afonsus1997/Yet-Another-Nixie-Clock/Hardware/Yet-Another-Nixie-Clock-Face/Yet-Another-Nixie-Clock-Face.kicad_pcb

## KiCad design Hardware/Yet-Another-Nixie-Clock-Face/Yet-Another-Nixie-Clock-Face.kicad_pcb (2025-10-29)

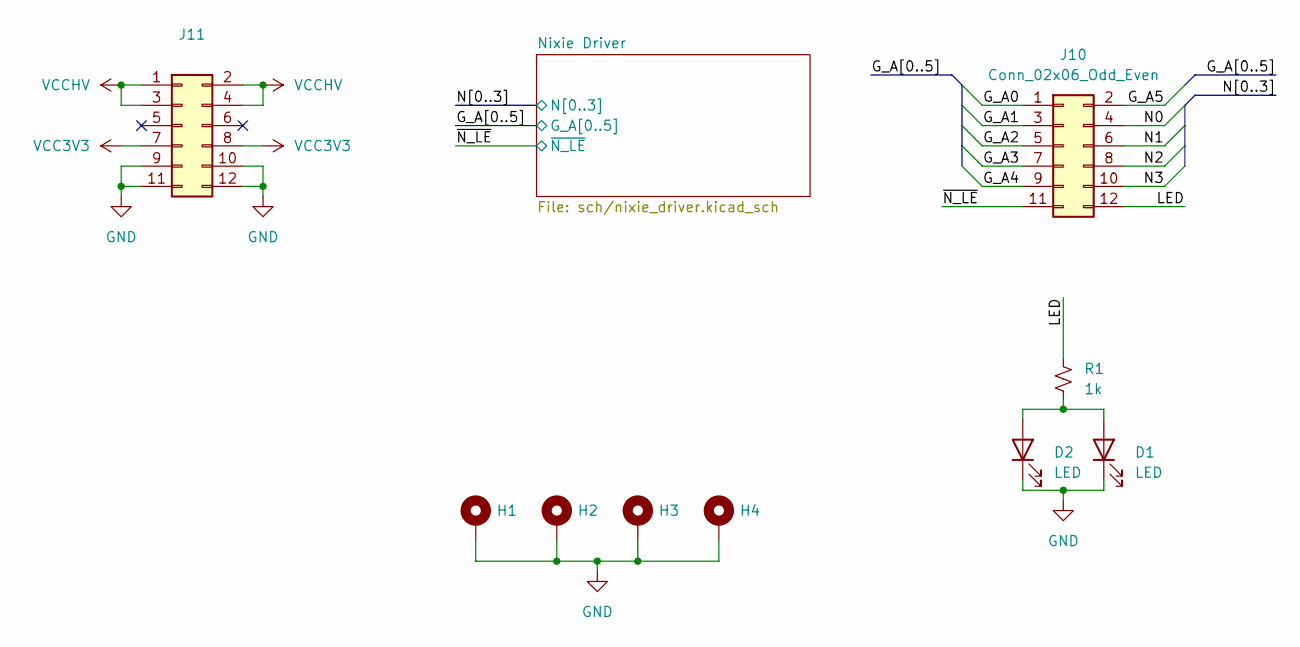
[picture p1: schematic Yet-Another-Nixie-Clock-Face.kicad_sch]

Parts:
D1, D2: LED; LED_0603_1608Metric
H1, H2, H3, H4: MountingHole_Pad; MountingHole_3.2mm_M3_Pad
J10, J11: Conn_02x06_Odd_Even; PinHeader_2x06_P2.54mm_Vertical_SMD; LCSC C3294464
R1: 1k; R_0603_1608Metric; LCSC C22548

Connections:
/G_A0: J10.1; also elsewhere on the board
/G_A1: J10.3; also elsewhere on the board
/G_A2: J10.5; also elsewhere on the board
/G_A3: J10.7; also elsewhere on the board
/G_A4: J10.9; also elsewhere on the board
/G_A5: J10.2; also elsewhere on the board
/LED: J10.12, R1.2
/N0: J10.4; also elsewhere on the board
/N1: J10.6; also elsewhere on the board
/N2: J10.8; also elsewhere on the board
/N3: J10.10; also elsewhere on the board
/~N_LE: J10.11; also elsewhere on the board
GND: D1.1 (K), D2.1 (K), H1.1, H2.1, H3.1, H4.1, J11.9, J11.10, J11.11, J11.12; also elsewhere on the board
unnamed: D1.2 (A), D2.2 (A), R1.1
VCC3V3: J11.7, J11.8; also elsewhere on the board
VCCHV: J11.1, J11.2, J11.3, J11.4; also elsewhere on the board

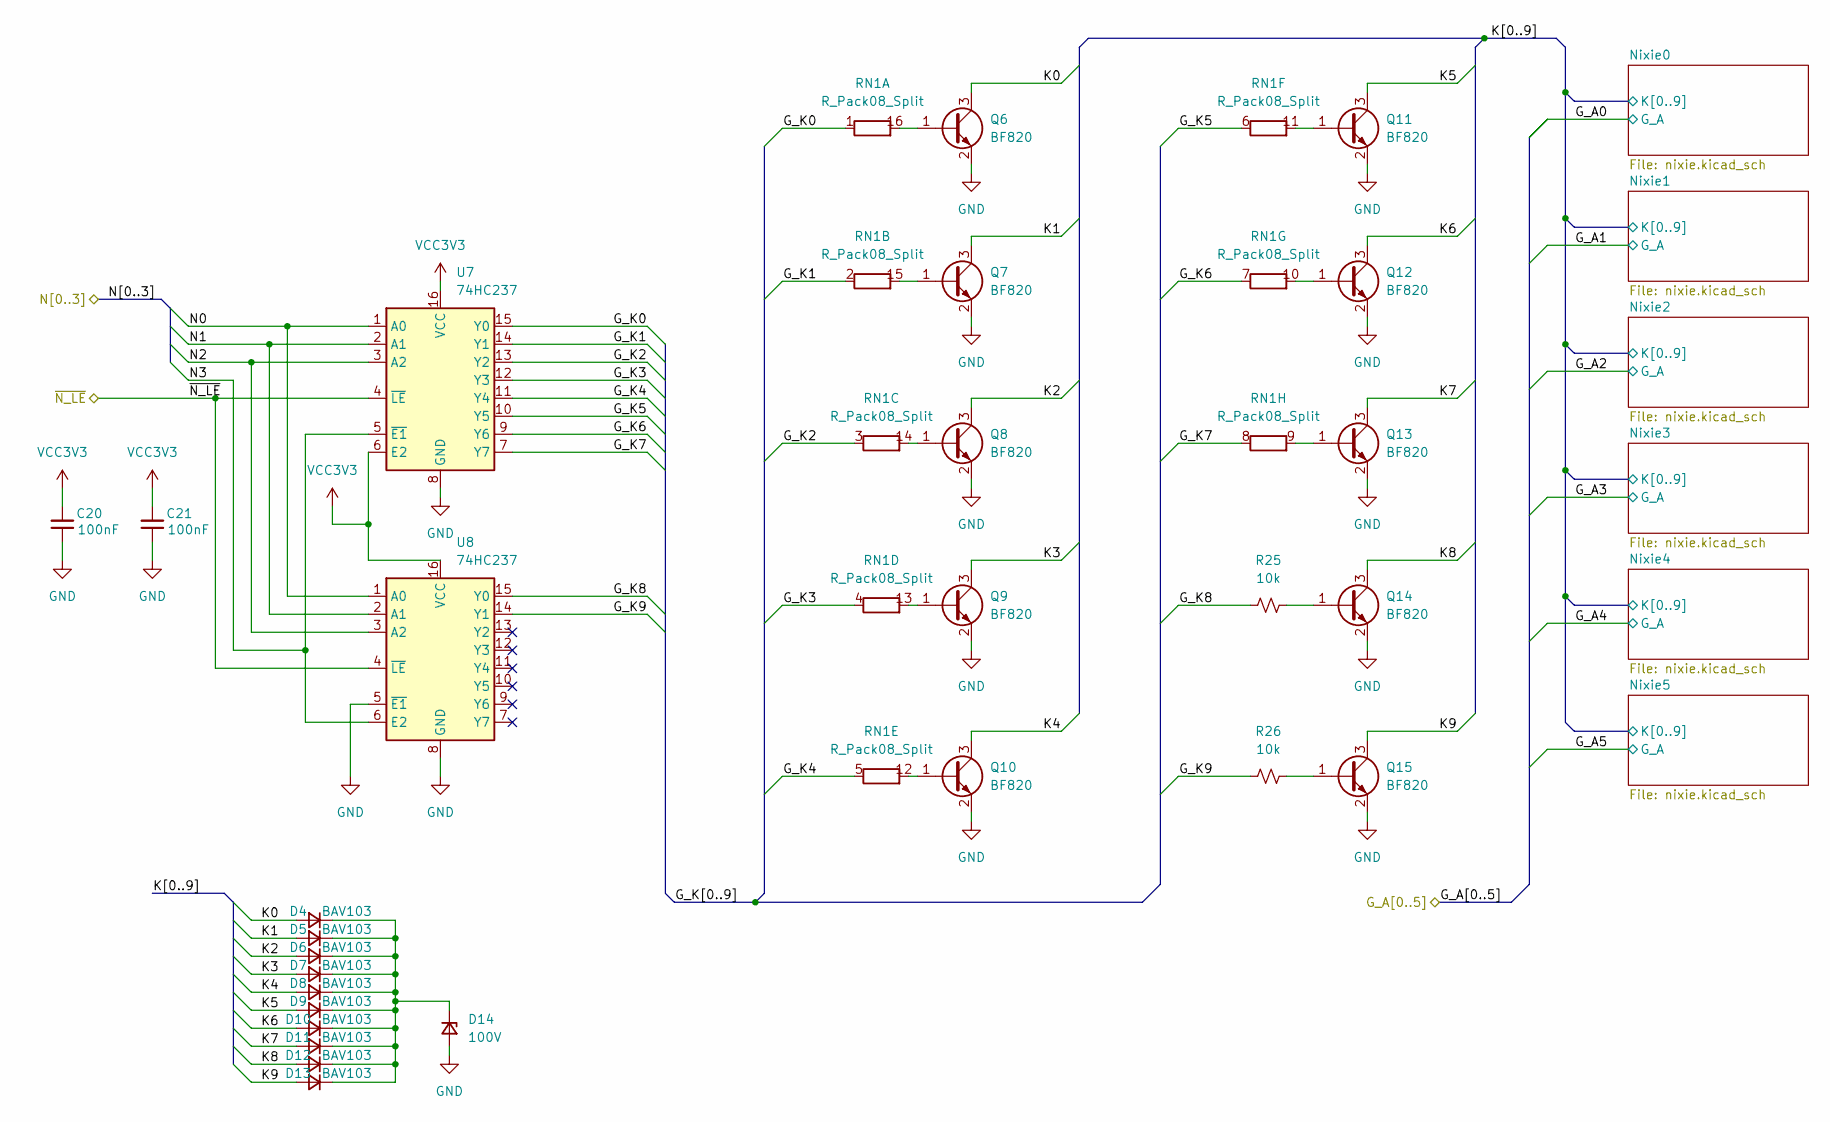
[picture p2: schematic nixie_driver.kicad_sch]

Parts:
C20, C21: 100nF; C_0603_1608Metric; LCSC C92490
D4, D5, D6, D7, D8, D9, D10, D11, D12, D13: BAV103; D_MiniMELF; LCSC C3313132
D14: 100V; D_SMA; LCSC C3014322
Q6, Q7, Q8, Q9, Q10, Q11, Q12, Q13, Q14, Q15: BF820; TSOT-23; LCSC C426796
R25, R26: 10k; R_0603_1608Metric; LCSC C98220
RN1: R_Pack08_Split; RES-ARRAY-SMD_0402-16P-L4.0-W1.6-BL-2; LCSC C326649
U7, U8: 74HC237; TSSOP-16_4.4x5mm_P0.65mm; LCSC C2674656

Connections:
/N0: U7.1 (A0), U8.1 (A0); also elsewhere on the board
/N1: U7.2 (A1), U8.2 (A1); also elsewhere on the board
/N2: U7.3 (A2), U8.3 (A2); also elsewhere on the board
/N3: U7.5 (~E1), U8.6 (E2); also elsewhere on the board
/Nixie Driver/G_K0: RN1.1 (R1.1), U7.15 (Y0)
/Nixie Driver/G_K1: RN1.2 (R2.1), U7.14 (Y1)
/Nixie Driver/G_K2: RN1.3 (R3.1), U7.13 (Y2)
/Nixie Driver/G_K3: RN1.4 (R4.1), U7.12 (Y3)
/Nixie Driver/G_K4: RN1.5 (R5.1), U7.11 (Y4)
/Nixie Driver/G_K5: RN1.6 (R6.1), U7.10 (Y5)
/Nixie Driver/G_K6: RN1.7 (R7.1), U7.9 (Y6)
/Nixie Driver/G_K7: RN1.8 (R8.1), U7.7 (Y7)
/Nixie Driver/G_K8: R25.1, U8.15 (Y0)
/Nixie Driver/G_K9: R26.1, U8.14 (Y1)
/Nixie Driver/K0: D4.2 (A), Q6.3 (C); also elsewhere on the board
/Nixie Driver/K1: D5.2 (A), Q7.3 (C); also elsewhere on the board
/Nixie Driver/K2: D6.2 (A), Q8.3 (C); also elsewhere on the board
/Nixie Driver/K3: D7.2 (A), Q9.3 (C); also elsewhere on the board
/Nixie Driver/K4: D8.2 (A), Q10.3 (C); also elsewhere on the board
/Nixie Driver/K5: D9.2 (A), Q11.3 (C); also elsewhere on the board
/Nixie Driver/K6: D10.2 (A), Q12.3 (C); also elsewhere on the board
/Nixie Driver/K7: D11.2 (A), Q13.3 (C); also elsewhere on the board
/Nixie Driver/K8: D12.2 (A), Q14.3 (C); also elsewhere on the board
/Nixie Driver/K9: D13.2 (A), Q15.3 (C); also elsewhere on the board
/~N_LE: U7.4 (~LE), U8.4 (~LE); also elsewhere on the board
GND: C20.1, C21.1, D14.2 (A), Q6.2 (E), Q7.2 (E), Q8.2 (E), Q9.2 (E), Q10.2 (E), Q11.2 (E), Q12.2 (E), Q13.2 (E), Q14.2 (E), Q15.2 (E), U7.8 (GND), U8.5 (~E1), U8.8 (GND); also elsewhere on the board
unnamed: D4.1 (K), D5.1 (K), D6.1 (K), D7.1 (K), D8.1 (K), D9.1 (K), D10.1 (K), D11.1 (K), D12.1 (K), D13.1 (K), D14.1 (K)
unnamed: Q6.1 (B), RN1.16 (R1.2)
unnamed: Q7.1 (B), RN1.15 (R2.2)
unnamed: Q8.1 (B), RN1.14 (R3.2)
unnamed: Q9.1 (B), RN1.13 (R4.2)
unnamed: Q10.1 (B), RN1.12 (R5.2)
unnamed: Q11.1 (B), RN1.11 (R6.2)
unnamed: Q12.1 (B), RN1.10 (R7.2)
unnamed: Q13.1 (B), RN1.9 (R8.2)
unnamed: Q14.1 (B), R25.2
unnamed: Q15.1 (B), R26.2
VCC3V3: C20.2, C21.2, U7.6 (E2), U7.16 (VCC), U8.16 (VCC); also elsewhere on the board

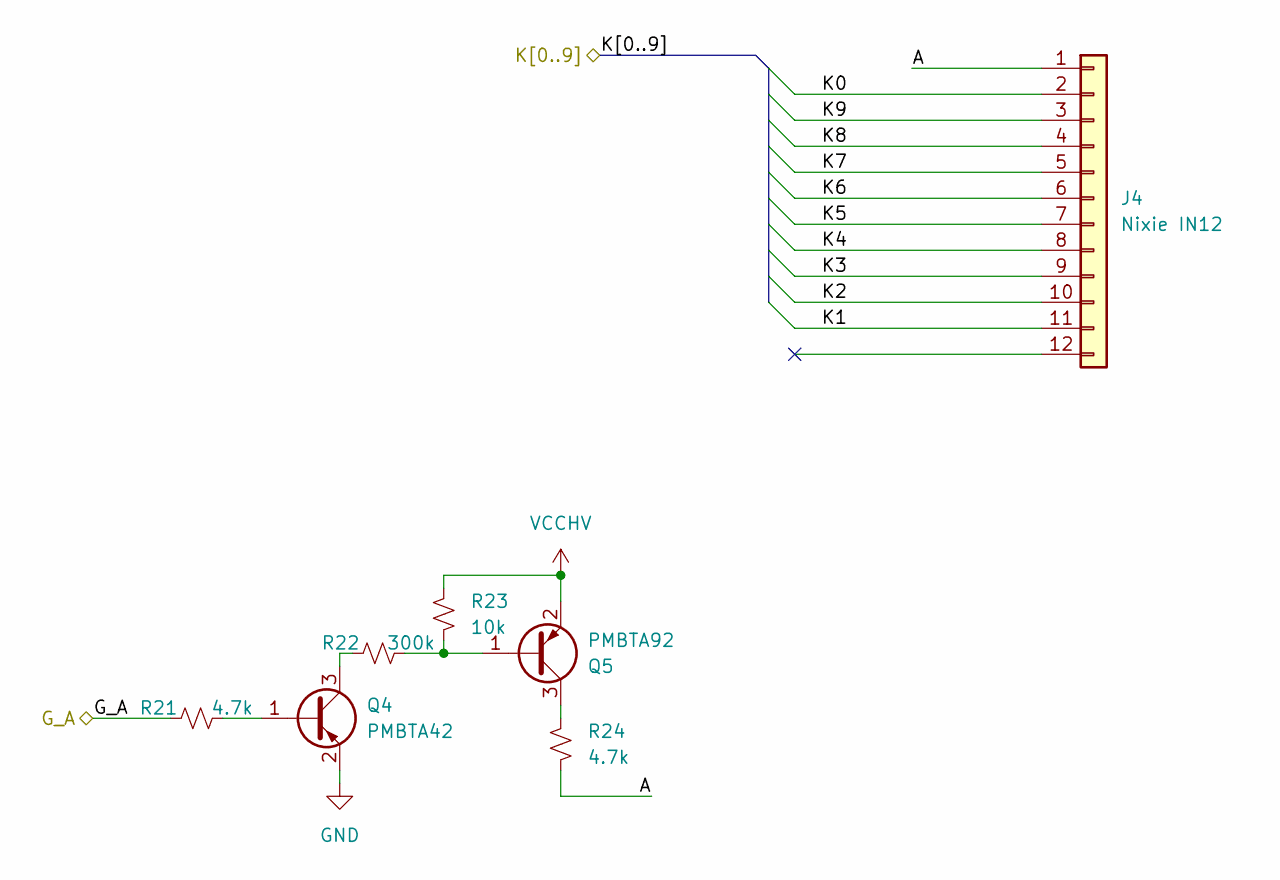
[picture p3: schematic nixie.kicad_sch]

Parts:
J4: Nixie IN12; IN_12B_Socket
Q4: PMBTA42; SOT-23; LCSC C417384
Q5: PMBTA92; SOT-23; LCSC C282560
R21, R24: 4.7k; R_0603_1608Metric; LCSC C99782
R22: 300k; R_0603_1608Metric; LCSC C114667
R23: 10k; R_0603_1608Metric; LCSC C98220

Connections:
/G_A0: R21.2; also elsewhere on the board
/Nixie Driver/K0: J4.2; also elsewhere on the board
/Nixie Driver/K1: J4.11; also elsewhere on the board
/Nixie Driver/K2: J4.10; also elsewhere on the board
/Nixie Driver/K3: J4.9; also elsewhere on the board
/Nixie Driver/K4: J4.8; also elsewhere on the board
/Nixie Driver/K5: J4.7; also elsewhere on the board
/Nixie Driver/K6: J4.6; also elsewhere on the board
/Nixie Driver/K7: J4.5; also elsewhere on the board
/Nixie Driver/K8: J4.4; also elsewhere on the board
/Nixie Driver/K9: J4.3; also elsewhere on the board
/Nixie Driver/Nixie0/A: J4.1, R24.2
GND: Q4.2 (E); also elsewhere on the board
unnamed: Q4.1 (B), R21.1
unnamed: Q4.3 (C), R22.2
unnamed: Q5.1 (B), R22.1, R23.2
unnamed: Q5.3 (C), R24.1
VCCHV: Q5.2 (E), R23.1; also elsewhere on the board

Parts of its further copies:
J5, J6, J7, J8, J9: Nixie IN12; IN_12B_Socket
Q16, Q18, Q20, Q22, Q24: PMBTA42; SOT-23; LCSC C417384
Q17, Q19, Q21, Q23, Q25: PMBTA92; SOT-23; LCSC C282560
R27, R30, R31, R34, R35, R38, R39, R42, R43, R46: 4.7k; R_0603_1608Metric; LCSC C99782
R28, R32, R36, R40, R44: 300k; R_0603_1608Metric; LCSC C114667
R29, R33, R37, R41, R45: 10k; R_0603_1608Metric; LCSC C98220

Connections of its further copies:
/G_A1: R27.2; also elsewhere on the board
/G_A2: R31.2; also elsewhere on the board
/G_A3: R35.2; also elsewhere on the board
/G_A4: R39.2; also elsewhere on the board
/G_A5: R43.2; also elsewhere on the board
/Nixie Driver/K0: J5.2, J6.2, J7.2, J8.2, J9.2; also elsewhere on the board
/Nixie Driver/K1: J5.11, J6.11, J7.11, J8.11, J9.11; also elsewhere on the board
/Nixie Driver/K2: J5.10, J6.10, J7.10, J8.10, J9.10; also elsewhere on the board
/Nixie Driver/K3: J5.9, J6.9, J7.9, J8.9, J9.9; also elsewhere on the board
/Nixie Driver/K4: J5.8, J6.8, J7.8, J8.8, J9.8; also elsewhere on the board
/Nixie Driver/K5: J5.7, J6.7, J7.7, J8.7, J9.7; also elsewhere on the board
/Nixie Driver/K6: J5.6, J6.6, J7.6, J8.6, J9.6; also elsewhere on the board
/Nixie Driver/K7: J5.5, J6.5, J7.5, J8.5, J9.5; also elsewhere on the board
/Nixie Driver/K8: J5.4, J6.4, J7.4, J8.4, J9.4; also elsewhere on the board
/Nixie Driver/K9: J5.3, J6.3, J7.3, J8.3, J9.3; also elsewhere on the board
/Nixie Driver/Nixie1/A: J5.1, R30.2
/Nixie Driver/Nixie2/A: J6.1, R34.2
/Nixie Driver/Nixie3/A: J7.1, R38.2
/Nixie Driver/Nixie4/A: J8.1, R42.2
/Nixie Driver/Nixie5/A: J9.1, R46.2
GND: Q16.2 (E), Q18.2 (E), Q20.2 (E), Q22.2 (E), Q24.2 (E); also elsewhere on the board
unnamed: Q16.1 (B), R27.1
unnamed: Q16.3 (C), R28.2
unnamed: Q17.1 (B), R28.1, R29.2
unnamed: Q17.3 (C), R30.1
unnamed: Q18.1 (B), R31.1
unnamed: Q18.3 (C), R32.2
unnamed: Q19.1 (B), R32.1, R33.2
unnamed: Q19.3 (C), R34.1
unnamed: Q20.1 (B), R35.1
unnamed: Q20.3 (C), R36.2
unnamed: Q21.1 (B), R36.1, R37.2
unnamed: Q21.3 (C), R38.1
unnamed: Q22.1 (B), R39.1
unnamed: Q22.3 (C), R40.2
unnamed: Q23.1 (B), R40.1, R41.2
unnamed: Q23.3 (C), R42.1
unnamed: Q24.1 (B), R43.1
unnamed: Q24.3 (C), R44.2
unnamed: Q25.1 (B), R44.1, R45.2
unnamed: Q25.3 (C), R46.1
VCCHV: Q17.2 (E), Q19.2 (E), Q21.2 (E), Q23.2 (E), Q25.2 (E), R29.1, R33.1, R37.1, R41.1, R45.1; also elsewhere on the board

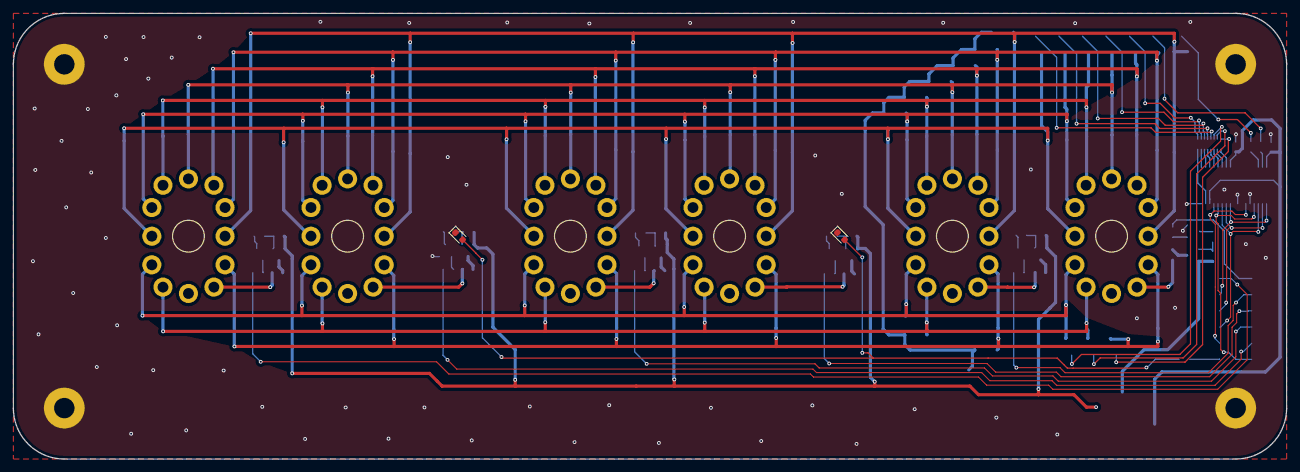
[picture p4: board Yet-Another-Nixie-Clock-Face.kicad_pcb from above]

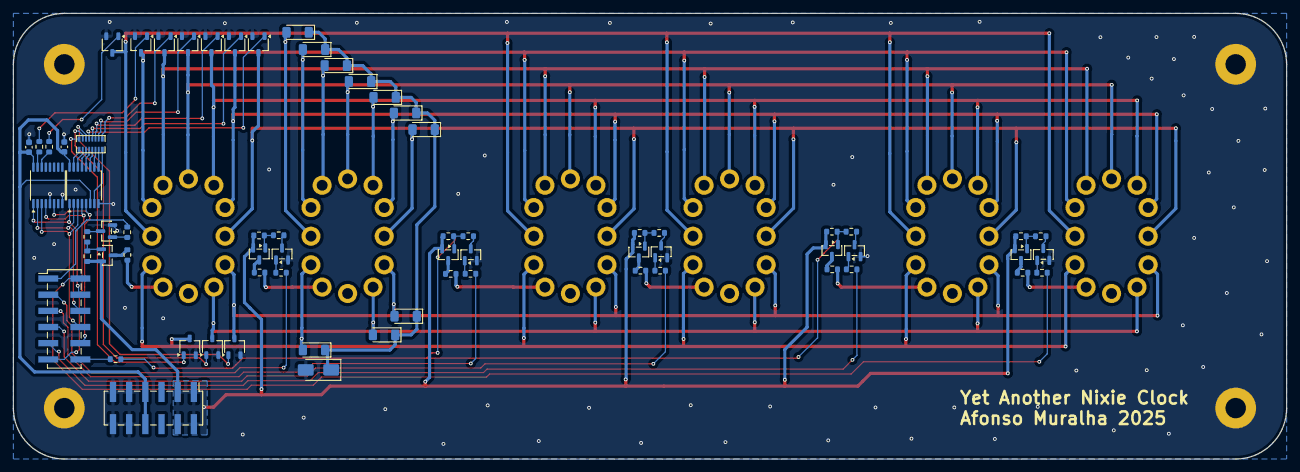
[picture p5: board Yet-Another-Nixie-Clock-Face.kicad_pcb from below]

Board: 2 copper layers, 200.0 x 70.0 mm, 79 parts (67 on the bottom side), 77 nets.
