afonsus1997/Yet-Another-Nixie-Clock/Hardware/Yet-Another-Nixie-Clock-Processing/Yet-Another-Nixie-Clock-Processing.kicad_pcb

## KiCad design Hardware/Yet-Another-Nixie-Clock-Processing/Yet-Another-Nixie-Clock-Processing.kicad_pcb (2025-10-29)

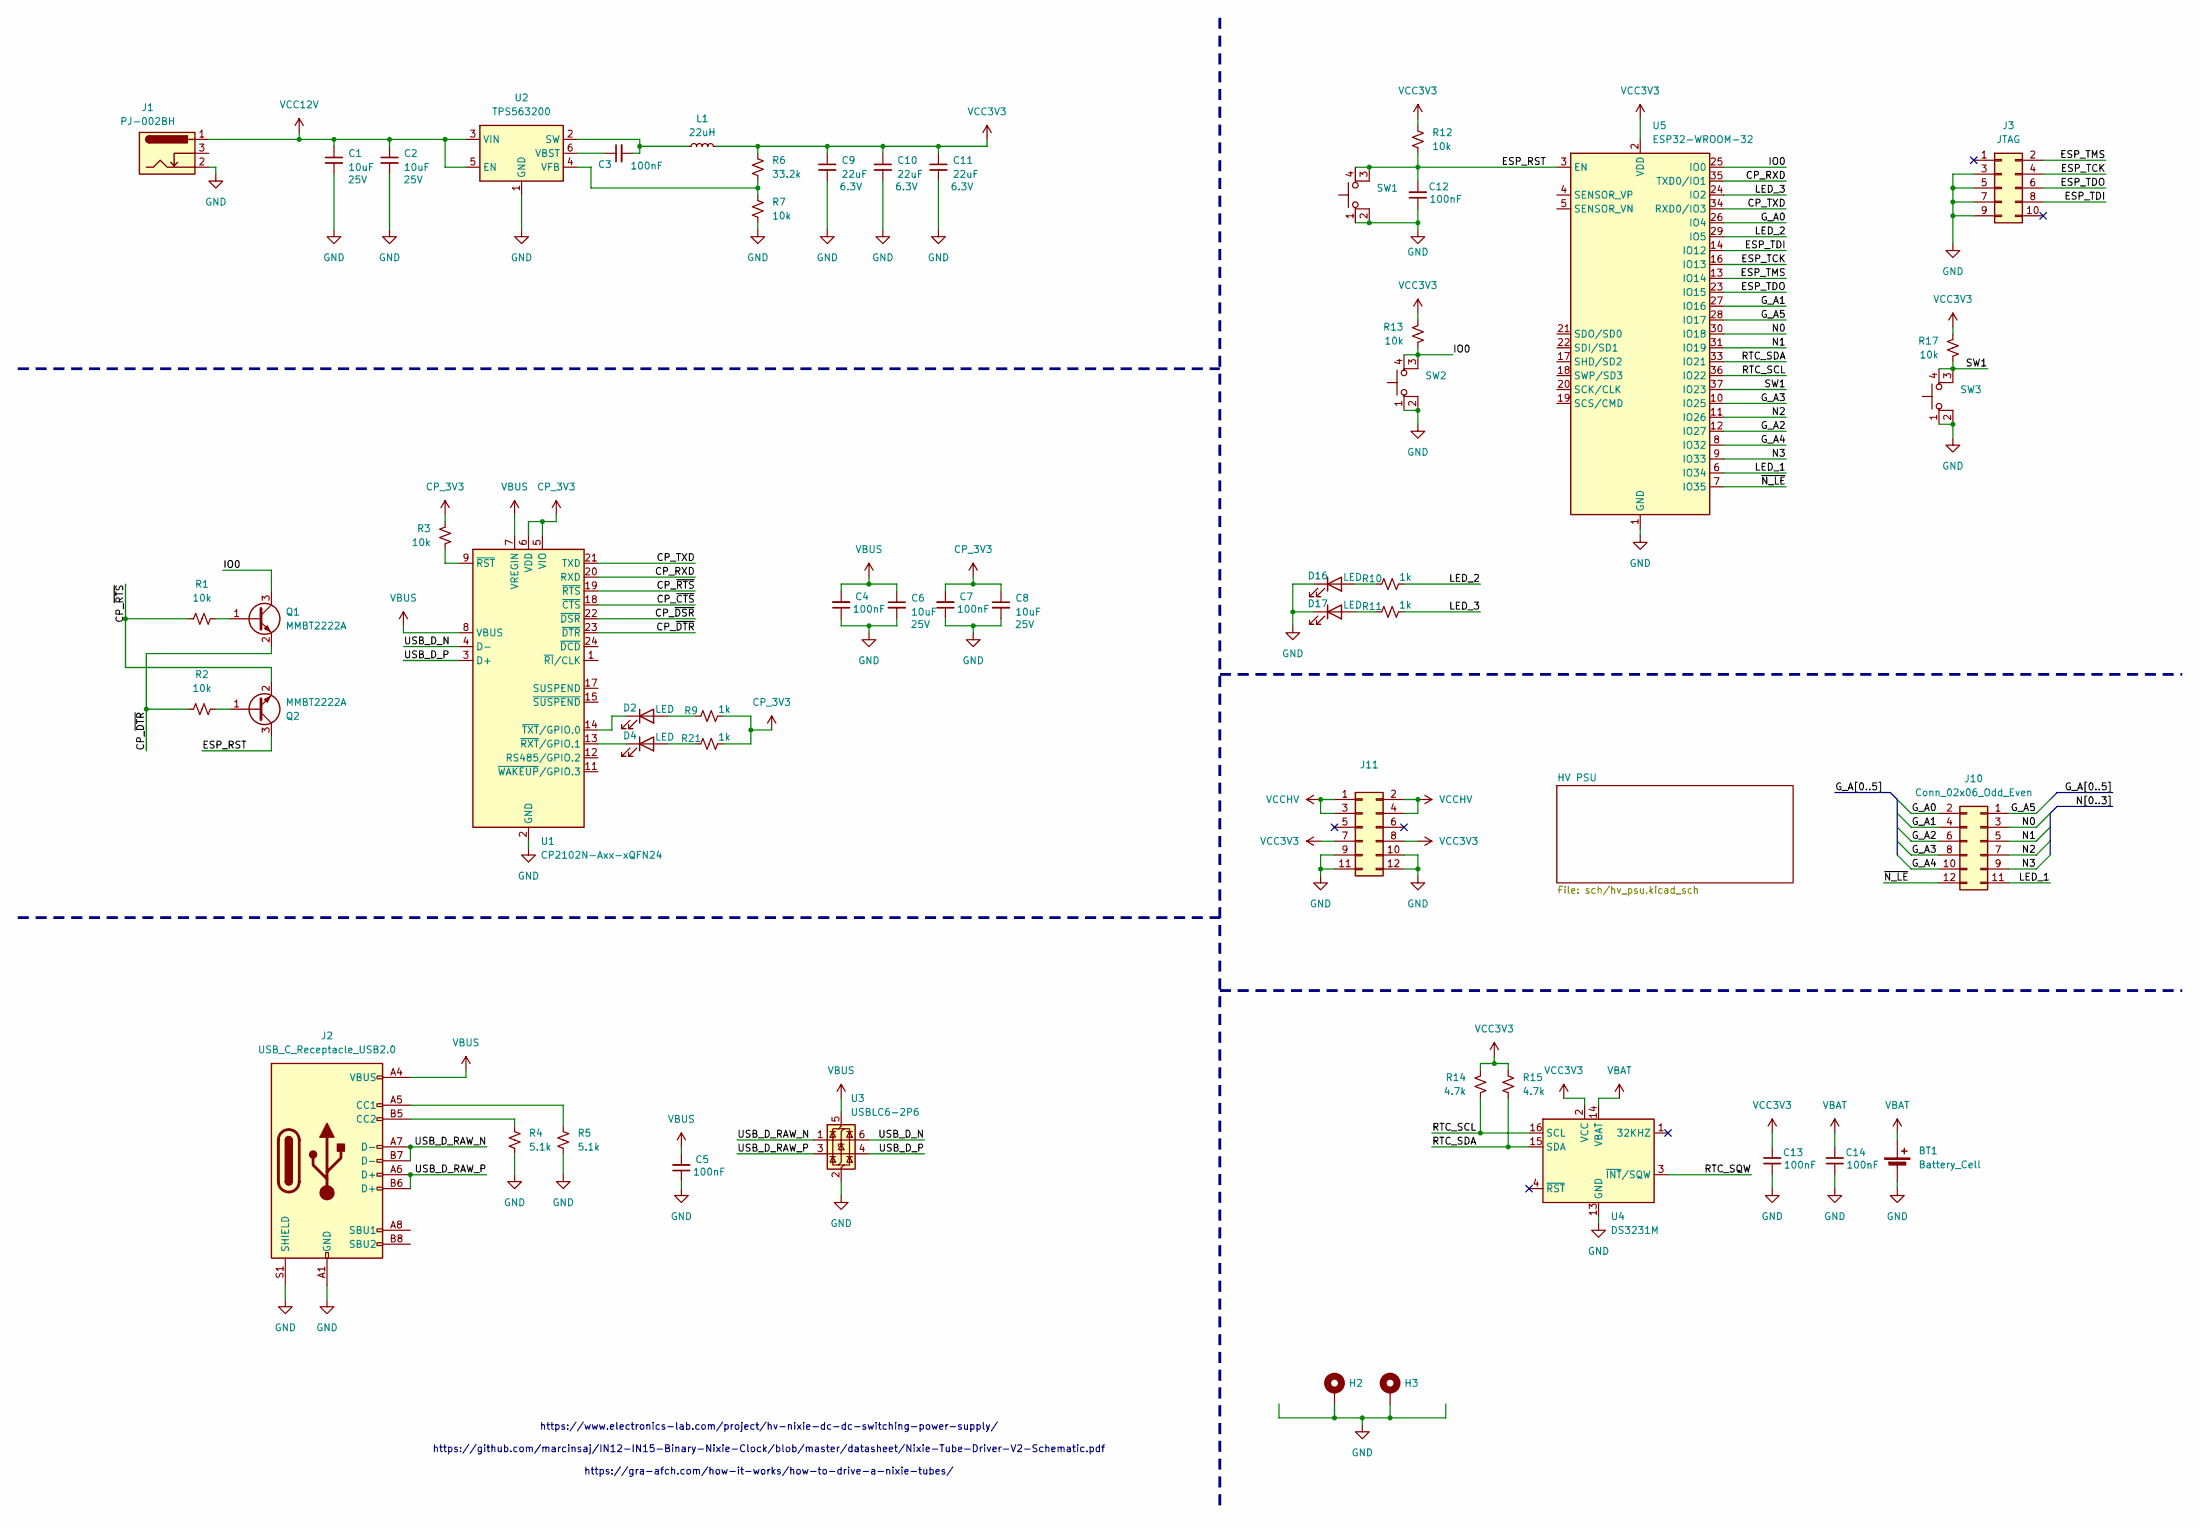
[picture p6: schematic Yet-Another-Nixie-Clock-Processing.kicad_sch]

Parts:
BT1: Battery_Cell; BAT-TH_CR2032-BS-6-1
C1, C2, C6, C8: 10uF; C_0603_1608Metric; Voltage 25V; LCSC C96446
C3, C4, C5, C7, C12, C13, C14: 100nF; C_0603_1608Metric; LCSC C92490
C9, C10, C11: 22uF; C_0603_1608Metric; Voltage 6.3V; LCSC C109448
D2, D4, D16, D17: LED; LED_0603_1608Metric
H2, H3: MountingHole_Pad; MountingHole_3.2mm_M3_Pad
J1: PJ-002BH; CUI_PJ-002BH; MANUFACTURER_PART_NUMBER PJ-002BH; LCSC C22359705
J2: USB_C_Receptacle_USB2.0; USB_C_Receptacle_HCTL_HC-TYPE-C-16P-01A; LCSC C2894897
J3: JTAG; IDC-Header_2x05_P2.54mm_Vertical; LCSC C573025
J10, J11: Conn_02x06_Odd_Even; PinHeader_2x06_P2.54mm_Vertical_SMD; LCSC C2685123
L1: 22uH; L_APV_APH0615; LCSC C842909
Q1, Q2: MMBT2222A; SOT-23; LCSC C82460
R1, R2, R3, R7, R12, R13, R17: 10k; R_0603_1608Metric; LCSC C98220
R4, R5: 5.1k; R_0402_1005Metric; LCSC C407575
R6: 33.2k; R_0603_1608Metric; LCSC C706161
R9, R10, R11, R21: 1k; R_0603_1608Metric; LCSC C22548
R14, R15: 4.7k; R_0603_1608Metric; LCSC C99782
SW1, SW2, SW3: SW_MEC_5E; SW_SKRPACE010; LCSC C139797
U1: CP2102N-Axx-xQFN24; QFN-24-1EP_4x4mm_P0.5mm_EP2.6x2.6mm; LCSC C969151
U2: TPS563200; SOT-23-6; LCSC C97253
U3: USBLC6-2P6; SOT-666; LCSC C2827693
U4: DS3231M; SOIC-16W_7.5x10.3mm_P1.27mm; LCSC C722467
U5: ESP32-WROOM-32; LCSC C82899

Connections:
/CP_RXD: U1.20 (RXD), U5.35 (TXD0/IO1)
/CP_TXD: U1.21 (TXD), U5.34 (RXD0/IO3)
/CP_~CTS: U1.18 (~CTS)
/CP_~DSR: U1.22 (~DSR)
/CP_~DTR: Q1.2 (E), R2.1, U1.23 (~DTR)
/CP_~RTS: Q2.2 (E), R1.1, U1.19 (~RTS)
/ESP_RST: C12.2, Q2.3 (C), R12.2, SW1.3 (K), SW1.4 (A), U5.3 (EN)
/ESP_TCK: J3.4, U5.16 (IO13)
/ESP_TDI: J3.8, U5.14 (IO12)
/ESP_TDO: J3.6, U5.23 (IO15)
/ESP_TMS: J3.2, U5.13 (IO14)
/G_A0: J10.2, U5.26 (IO4)
/G_A1: J10.4, U5.27 (IO16)
/G_A2: J10.6, U5.12 (IO27)
/G_A3: J10.8, U5.10 (IO25)
/G_A4: J10.10, U5.8 (IO32)
/G_A5: J10.1, U5.28 (IO17)
/IO0: Q1.3 (C), R13.2, SW2.3 (K), SW2.4 (A), U5.25 (IO0)
/LED_1: J10.11, U5.6 (IO34)
/LED_2: R10.1, U5.29 (IO5)
/LED_3: R11.1, U5.24 (IO2)
/N0: J10.3, U5.30 (IO18)
/N1: J10.5, U5.31 (IO19)
/N2: J10.7, U5.11 (IO26)
/N3: J10.9, U5.9 (IO33)
/RTC_SCL: R14.2, U4.16 (SCL), U5.36 (IO22)
/RTC_SDA: R15.2, U4.15 (SDA), U5.33 (IO21)
/RTC_SQW: U4.3 (~INT/SQW)
/SW1: R17.2, SW3.3 (K), SW3.4 (A), U5.37 (IO23)
/USB_D_N: U1.4 (D-), U3.6 (I/O1)
/USB_D_P: U1.3 (D+), U3.4 (I/O2)
/USB_D_RAW_N: J2.A7 (D-), J2.B7 (D-), U3.1 (I/O1)
/USB_D_RAW_P: J2.A6 (D+), J2.B6 (D+), U3.3 (I/O2)
/~N_LE: J10.12, U5.7 (IO35)
CP_3V3: C7.2, C8.1, R3.1, R9.1, R21.1, U1.5 (VIO), U1.6 (VDD)
GND: BT1.2 (-), C1.2, C2.2, C4.1, C5.1, C6.2, C7.1, C8.2, C9.2, C10.2, C11.2, C12.1, C13.1, C14.1, D16.1 (K), D17.1 (K), H2.1, H3.1, J1.2, J2.A1 (GND), J2.A12 (GND), J2.B1 (GND), J2.B12 (GND), J2.S1 (SHIELD), J3.3, J3.5, J3.7, J3.9, J11.9, J11.10, J11.11, J11.12, R4.2, R5.2, R7.2, SW1.1, SW1.2, SW2.1, SW2.2, SW3.1, SW3.2, U1.2 (GND), U1.25 (GND), U2.1 (GND), U3.2 (GND), U4.5 (GND), U4.6 (GND), U4.7 (GND), U4.8 (GND), U4.9 (GND), U4.10 (GND), U4.11 (GND), U4.12 (GND), U4.13 (GND), U5.1 (GND), U5.15 (GND), U5.38 (GND), U5.39 (GND); also elsewhere on the board
unnamed: D2.2 (A), R9.2
unnamed: D2.1 (K), U1.14 (~TXT/GPIO.0)
unnamed: D4.2 (A), R21.2
unnamed: D4.1 (K), U1.13 (~RXT/GPIO.1)
unnamed: D16.2 (A), R10.2
unnamed: D17.2 (A), R11.2
unnamed: J2.A5 (CC1), R5.1
unnamed: J2.B5 (CC2), R4.1
unnamed: Q1.1 (B), R1.2
unnamed: Q2.1 (B), R2.2
unnamed: R3.2, U1.9 (~RST)
unnamed: C3.2, L1.1, U2.2 (SW)
unnamed: C3.1, U2.6 (VBST)
unnamed: R6.2, R7.1, U2.4 (VFB)
VBAT: BT1.1 (+), C14.2, U4.14 (VBAT)
VBUS: C4.2, C5.2, C6.1, J2.A4 (VBUS), J2.A9 (VBUS), J2.B4 (VBUS), J2.B9 (VBUS), U1.7 (VREGIN), U1.8 (VBUS), U3.5 (VBUS)
VCC3V3: C9.1, C10.1, C11.1, C13.2, J11.7, J11.8, L1.2, R6.1, R12.1, R13.1, R14.1, R15.1, R17.1, U4.2 (VCC), U5.2 (VDD)
VCC12V: C1.1, C2.1, J1.1, U2.3 (VIN), U2.5 (EN); also elsewhere on the board
VCCHV: J11.1, J11.2, J11.3, J11.4; also elsewhere on the board

Notes on the sheet:
https://www.electronics-lab.com/project/hv-nixie-dc-dc-switching-power-supply/ https://github.com/marcinsaj/IN12-IN15-Binary-Nixie-Clock/blob/master/datasheet/Nixie-Tube-Driver-V2-Schematic.pdf https://gra-afch.com/how-it-works/how-to-drive-a-nixie-tubes/

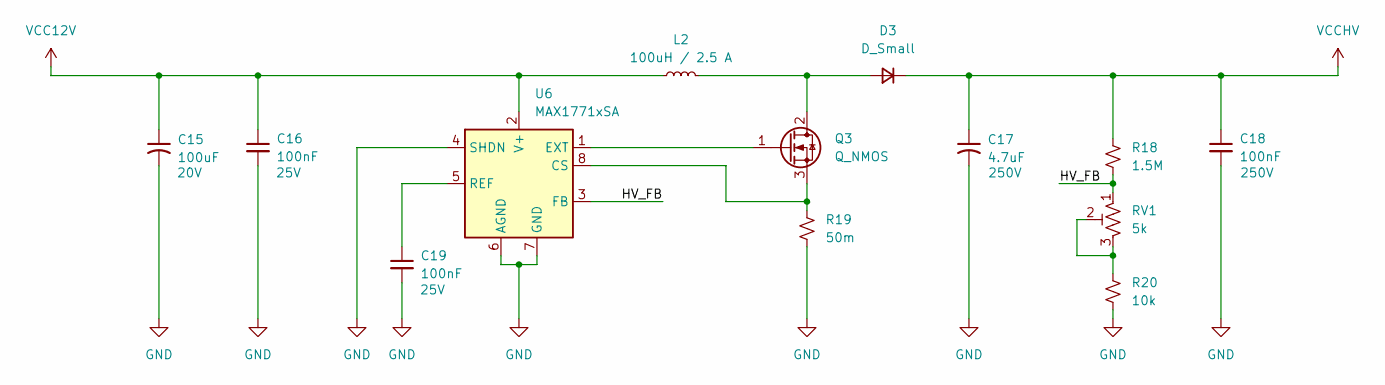
[picture p7: schematic hv_psu.kicad_sch]

Parts:
C15: 100uF; CP_EIA-7343-15_Kemet-W_HandSolder; Voltage 20V; LCSC C122302
C16, C19: 100nF; C_0603_1608Metric; Voltage 25V; LCSC C92490
C17: 4.7uF; C_Elec_8x10.2; Voltage 250V; LCSC C88702
C18: 100nF; C_1210_3225Metric; Voltage 250V; LCSC C52020
D3: D_Small; D_SMB_Handsoldering; LCSC C145321
L2: 100uH / 2.5 A; L_APV_APH0840; LCSC C2962892
Q3: Q_NMOS; TO-263-2; LCSC C39238
R18: 1.5M; R_0805_2012Metric; LCSC C118025
R19: 50m; R_1206_3216Metric; LCSC C149662
R20: 10k; R_0805_2012Metric; LCSC C269724
RV1: 5k; Potentiometer_Bourns_3314G_Vertical; LCSC C719180
U6: MAX1771xSA; SO-8_3.9x4.9mm_P1.27mm; LCSC C407903

Connections:
/HV PSU/HV_FB: R18.2, RV1.1, U6.3 (FB)
GND: C15.2, C16.2, C17.2, C18.2, C19.2, R19.2, R20.2, U6.4 (SHDN), U6.6 (AGND), U6.7 (GND); also elsewhere on the board
unnamed: D3.2 (A), L2.2, Q3.2 (D)
unnamed: Q3.1 (G), U6.1 (EXT)
unnamed: Q3.3 (S), R19.1, U6.8 (CS)
unnamed: R20.1, RV1.2, RV1.3
unnamed: C19.1, U6.5 (REF)
VCC12V: C15.1, C16.1, L2.1, U6.2 (V+); also elsewhere on the board
VCCHV: C17.1, C18.1, D3.1 (K), R18.1; also elsewhere on the board

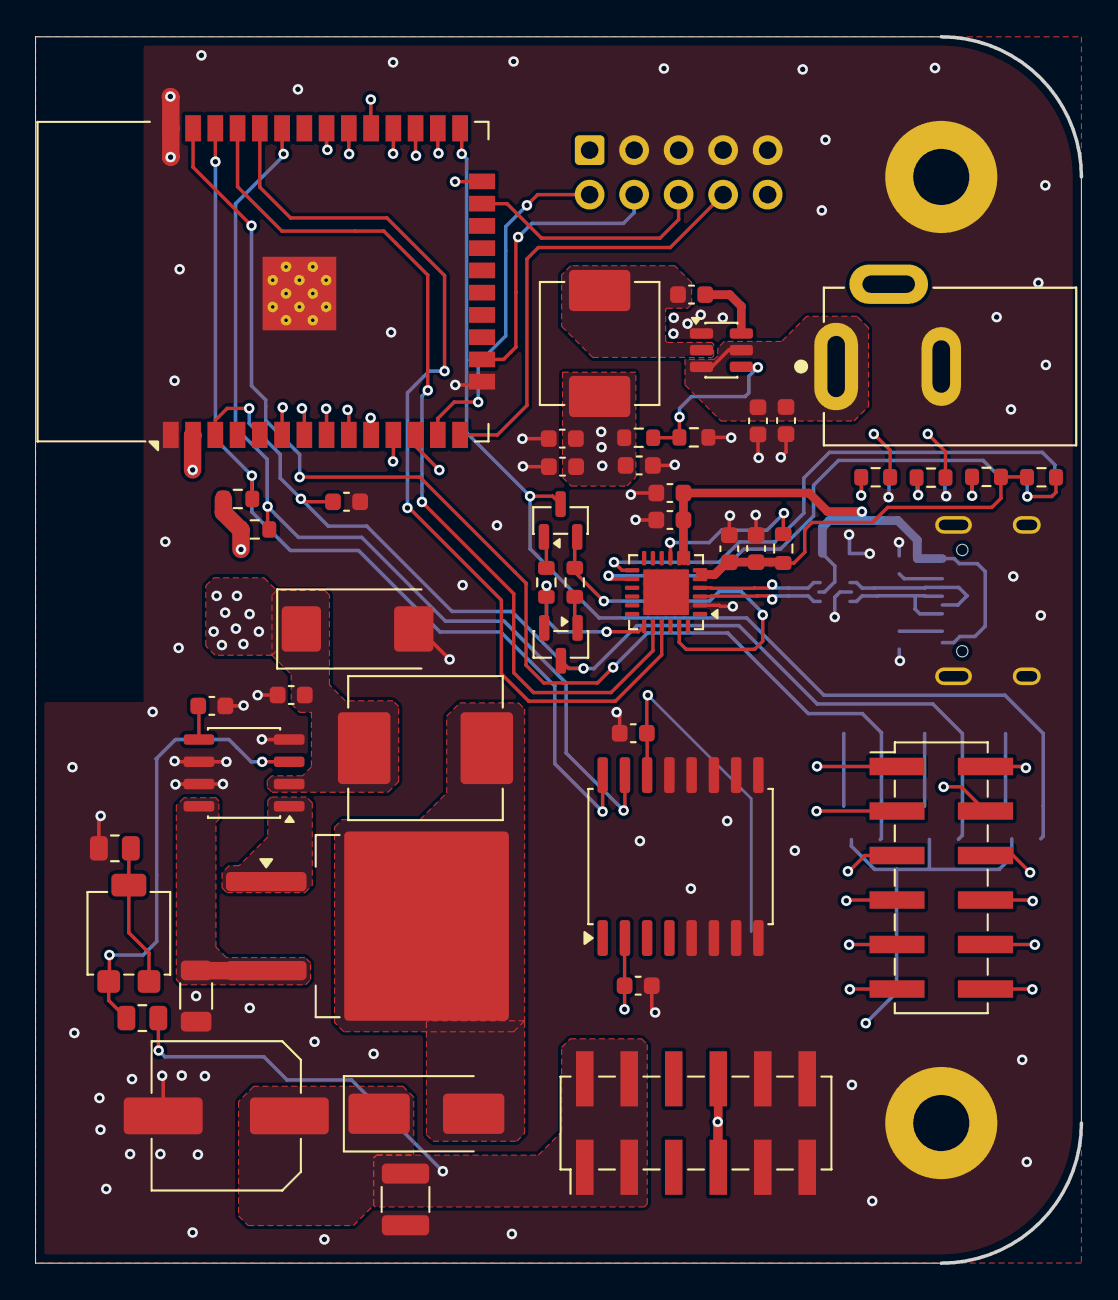
[picture p8: board Yet-Another-Nixie-Clock-Processing.kicad_pcb from above]

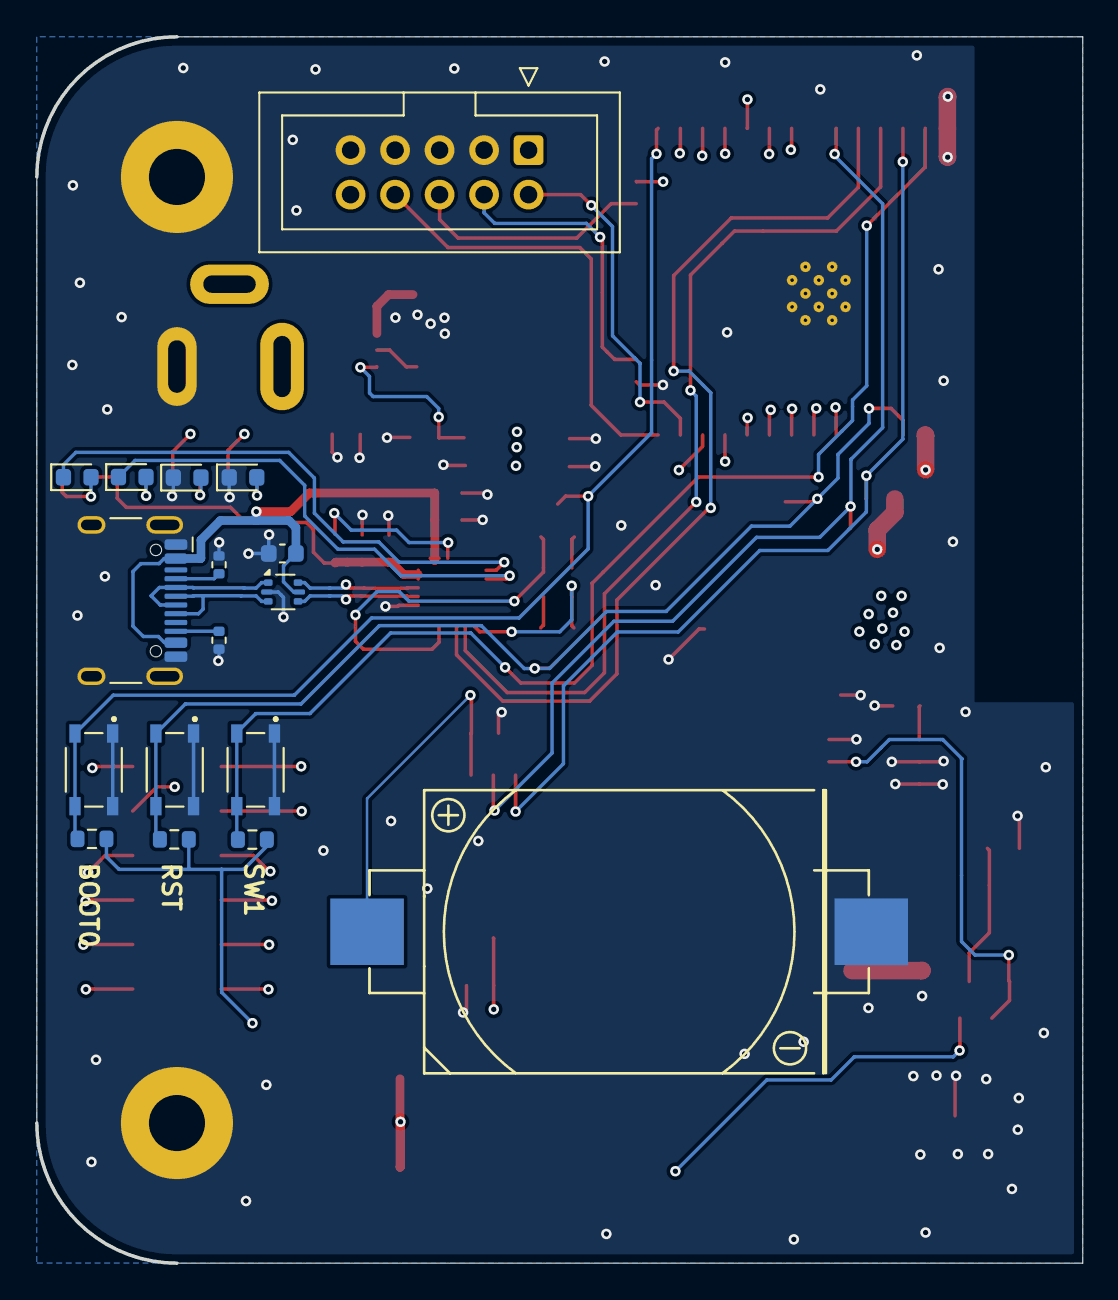
[picture p9: board Yet-Another-Nixie-Clock-Processing.kicad_pcb from below]

Board: 4 copper layers, 59.7 x 70.0 mm, 66 parts (17 on the bottom side), 58 nets.
