afonsus1997/Yet-Another-Nixie-Clock/Software/Yet-Another-Nixie-Clock/src/btn.cpp

#include "btn.h"

uint8_t btn_states[BUTTONS_TOTAL] = {0};


const int buttons_id[BUTTONS_TOTAL] = {BUTTON_USER};



lwbtn_btn_t btns[] = {

    {.arg = (void*)&buttons_id[BUTTON_USER]}

};


void btn_button_event(struct lwbtn* lw, struct lwbtn_btn* btn, lwbtn_evt_t evt) {
    if (evt == LWBTN_EVT_ONPRESS) {
        int btn_id = *(int*)btn->arg;
        // ui_process_button_event(btn_id); BTN HANDLING HERE
        Serial.println("User button pressed!");
    }
}

uint8_t prv_btn_get_state(struct lwbtn* lw, struct lwbtn_btn* btn) {
  switch (*(int*)btn->arg) {
    case BUTTON_USER:
      return !digitalRead(BUTTON_USER_PIN);
    default:
      return 0; // Button not pressed
  };
}

void btn_process(){
  lwbtn_process_ex(NULL, millis());
}

void btn_init(){
  pinMode(BUTTON_USER_PIN, INPUT);
  lwbtn_init_ex(NULL, btns, sizeof(btns) / sizeof(btns[0]), prv_btn_get_state, btn_button_event);
}
