afonsus1997/Yet-Another-Nixie-Clock/(commit log)

2025-10-25 Schematic advancements
    [Yet-Another-Nixie-Clock.kicad_sch, hv_psu.kicad_sch, nixie.kicad_sch, nixie_driver.kicad_sch, shift_register.kicad_sch]
2025-10-25 Schematic work
    [Yet-Another-Nixie-Clock.kicad_sch, nixie.kicad_sch, nixie_driver.kicad_sch]
2025-10-25 Schematic work and fixes
    [hv_psu.kicad_sch, nixie.kicad_sch, nixie_driver.kicad_sch]
2025-10-27 Schematic advancements, separated boards
    [Yet-Another-Nixie-Clock-Face.kicad_pcb, Yet-Another-Nixie-Clock-Face.kicad_sch, Yet-Another-Nixie-Clock-Processing.kicad_pcb, Yet-Another-Nixie-Clock-Processing.kicad_sch, Yet-Another-Nixie-Clock.kicad_pcb, hv_psu.kicad_sch, nixie.kicad_sch, nixie_driver.kicad_sch]
2025-10-27 Removed old board
    [Yet-Another-Nixie-Clock.kicad_pcb, Yet-Another-Nixie-Clock.kicad_sch, hv_psu.kicad_sch, nixie.kicad_sch, nixie_driver.kicad_sch, shift_register.kicad_sch]
2025-10-27 Minor improvements
    [Yet-Another-Nixie-Clock-Face.kicad_pcb]
2025-10-28 Major schematic and layout advancements
    [Yet-Another-Nixie-Clock-Face.kicad_pcb, Yet-Another-Nixie-Clock-Processing.kicad_pcb, Yet-Another-Nixie-Clock-Processing.kicad_sch]
2025-10-29 Minor touches. Fixed bom. Exported production files
    [Yet-Another-Nixie-Clock-Face.kicad_pcb, Yet-Another-Nixie-Clock-Face.kicad_sch, Yet-Another-Nixie-Clock-Processing.kicad_pcb, Yet-Another-Nixie-Clock-Processing.kicad_sch, hv_psu.kicad_sch, nixie.kicad_sch, nixie_driver.kicad_sch]
